yavor7512/cabinet_maker/tests/fixtures/pre-config/complete-cabinet-autocad.step

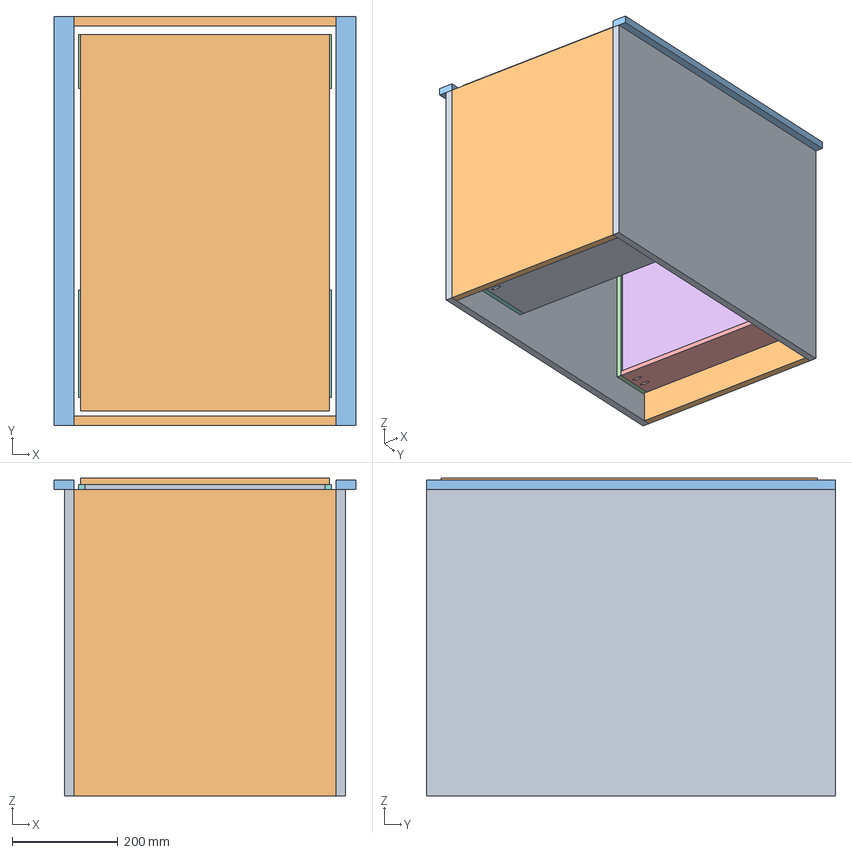
[picture p1: CAD file, 2026-10-23]
tests/fixtures/pre-config/complete-cabinet-autocad.step
570.0 x 773.0 x 600.5 mm
B12 - Left carcass side
B13 - Right carcass side
B14 - Carcass bottom
B15 - Carcass top
B16 - Left face-frame stile
B17 - Right face-frame stile
B01 - Left side
B02 - Right side
B03 - Front wall
B04 - Back wall
B05 - Bottom panel
S01 - Front left pocket screw 1 x 2
S02 - Front left pocket screw 2 x 2
S03 - Front right pocket screw 1 x 2
S04 - Front right pocket screw 2 x 2
S05 - Back left pocket screw 1 x 2
S06 - Back left pocket screw 2 x 2
S07 - Back right pocket screw 1 x 2
S08 - Back right pocket screw 2 x 2
B06 - Left side
B07 - Right side
B08 - Front wall
B09 - Back wall
B10 - Bottom panel
B11 - Applied drawer face
