yavor7512/cabinet_maker/tests/fixtures/pre-config/inner-drawer-477x523x102.step

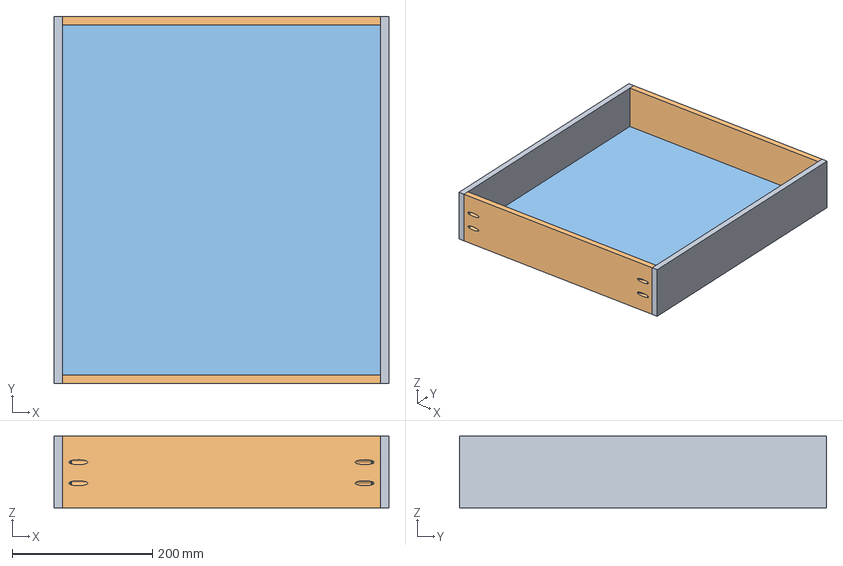
[picture p2: CAD file, 2026-10-23]
tests/fixtures/pre-config/inner-drawer-477x523x102.step
477.0 x 523.0 x 102.0 mm
B01 - Left side
B02 - Right side
B03 - Front wall
B04 - Back wall
B05 - Bottom panel
S01 - Front left pocket screw 1
S02 - Front left pocket screw 2
S03 - Front right pocket screw 1
S04 - Front right pocket screw 2
S05 - Back left pocket screw 1
S06 - Back left pocket screw 2
S07 - Back right pocket screw 1
S08 - Back right pocket screw 2
