yavor7512/cabinet_maker/tests/fixtures/pre-config/tall-front-bottom-aligned.step

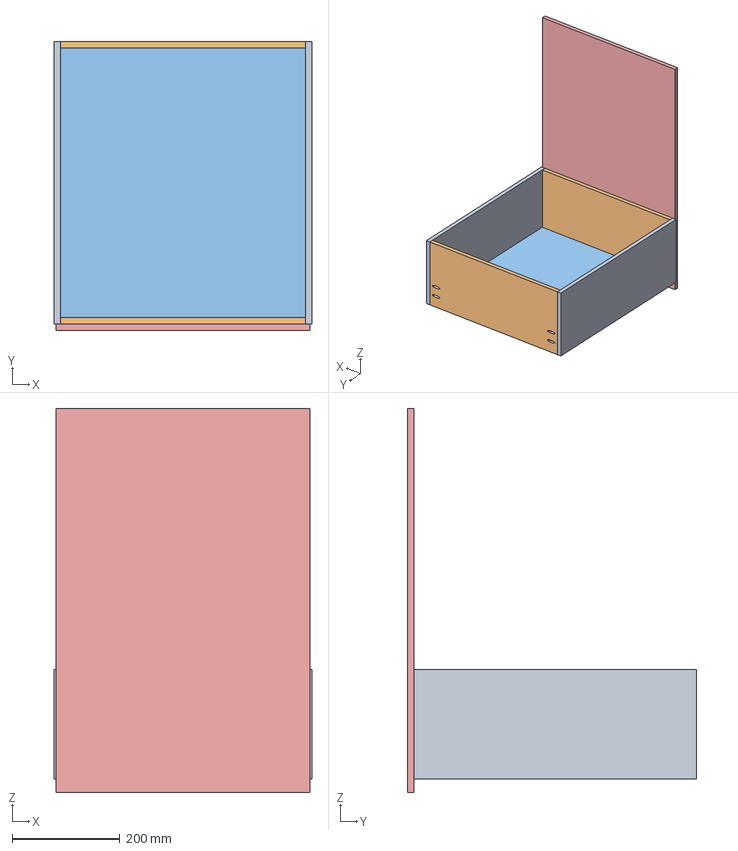
[picture p3: CAD file, 2026-10-23]
tests/fixtures/pre-config/tall-front-bottom-aligned.step
477.0 x 535.0 x 711.2 mm
B06 - Left side
B07 - Right side
B08 - Front wall
B09 - Back wall
B10 - Bottom panel
S01 - Front left pocket screw 1
S02 - Front left pocket screw 2
S03 - Front right pocket screw 1
S04 - Front right pocket screw 2
S05 - Back left pocket screw 1
S06 - Back left pocket screw 2
S07 - Back right pocket screw 1
S08 - Back right pocket screw 2
B11 - Applied drawer face
