yavor7512/cabinet_maker/tests/fixtures/pre-config/cabinet-carcass.step

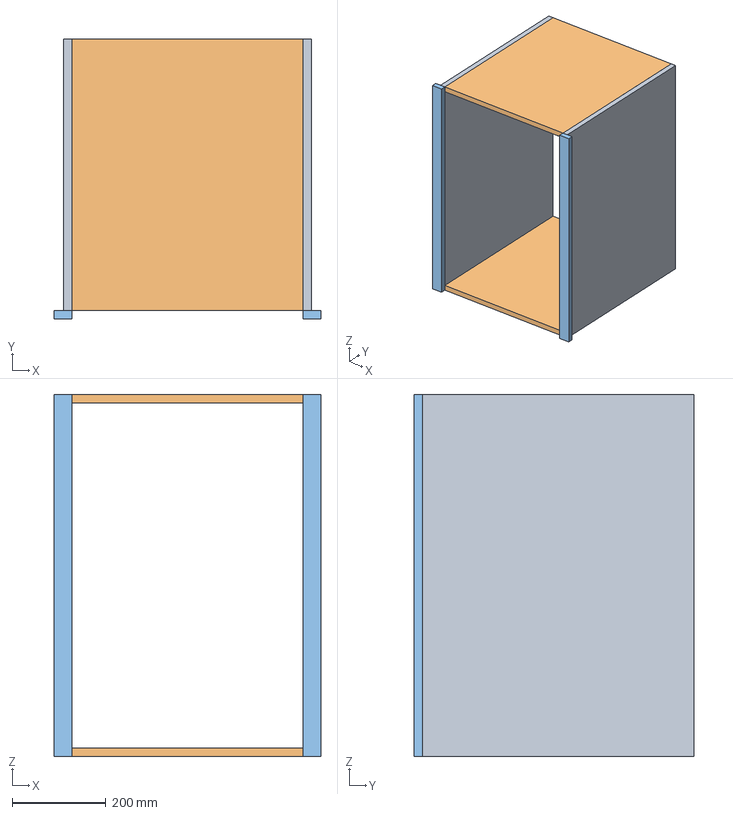
[picture p4: CAD file, 2026-10-23]
tests/fixtures/pre-config/cabinet-carcass.step
570.0 x 597.0 x 773.0 mm
B12 - Left carcass side
B13 - Right carcass side
B14 - Carcass bottom
B15 - Carcass top
B16 - Left face-frame stile
B17 - Right face-frame stile
