yavor7512/cabinet_maker/(list of files, cad)

Other CAD files:
tests/fixtures/pre-config/complete-cabinet.step
