yavor7512/cabinet_maker/tests/fixtures/pre-config/shop-packet.pdf

FABRICATION / PLYWOOD

# Plywood cutting plan

Production overview / Rectangular blanks first, machining second

2

SHEETS TO BUY

17

INDIVIDUAL BLANKS

24

SAW CUTS

5 mm

MAX. KERF ALLOWANCE

01 STOCK TO BUY

SHEET | PLYWOOD | STOCK SIZE | USABLE SIZE (MM) | BLANKS | CUTS
1.1 | 12 mm | 5x5 ft | 1524 x 1524 | 11 | 16
2.1 | 18 mm | 5x5 ft | 1524 x 1524 | 6 | 8

02 CUTTING WORKFLOW

1 Follow FROM and KEEP LEFT for each cut; see the cutting guide on the next page. 2 Mark every blank with its P ID before separating similar parts.
3 Machine flagged parts using the source model / drawings before assembly.

Grain: longest blank edge follows sheet X. Preserve the layout when turning panels.
Usable stock sizes assumed; no edge-trim allowance. No stacked cuts assumed.
Material / grade assumed uniform; sheets grouped by thickness. 16 hardware objects excluded.

Plan: shop workflow. Search is heuristic; minimum cut count is not proven.

SOURCE complete-cabinet.step

SHOP PACKET / DIMENSIONS IN MM / NOT TO SCALE | Page 1 / 5

# Keep the sized piece on the left

Use local measurements for every cut / Diagram positions use the maximum kerf allowance

01 PICK THE CORRECT SUBPANEL
FROM identifies the piece: S1 = this group's sheet 1; C4L = left piece from cut 4; C4R = right remainder. After each cut, label both sides CnL / CnR and retain any remainder referenced by a later cut.

02 ORIENT IT BEFORE MEASURING
V: put the diagram-left edge on your left. H: turn clockwise so the diagram-bottom edge is on your left.
Use the sheet diagram as the orientation reference each time. Turning a panel does not change its grain layout.

03 MEASURE KEEP LEFT TO THE NEAREST CUTTING EDGE
Measure from the current left reference edge to the blade tooth edge nearest the kept piece, not the blade centre. Reset this measurement for every cut. Do not use cumulative sheet coordinates or subtract the kerf.
KEEP LEFT | RIGHT REMAINDER
KEEP LEFT dimension | Kerf is taken from this side

04 FINISH REMAINDERS TO SIZE
The plan reserves 5 mm per cut. Smaller actual kerfs leave extra stock; finishing cuts remove it.
Finish even at a diagram edge. Skip a pass only if the piece measures to size; still use its CnL label.
The actual kerf must be no greater than 5 mm. Replan for a wider blade. Exact stock size and accurate setup still matter.

P IDs in LEFT PIECE mark finished blanks. Other left pieces and right remainders may need further cuts.

# Parts register

One row per physical blank. P IDs link this register to layouts and labels.

ID | PART / MODEL BOARD NAME | LENGTH | WIDTH | THICK. | QTY | FINISHING
P01 | B12 - Left carcass side | 773 | 579 | 18 | 1 | Blank
P02 | B13 - Right carcass side | 773 | 579 | 18 | 1 | Blank
P03 | B14 - Carcass bottom | 579 | 494 | 18 | 1 | Blank
P04 | B15 - Carcass top | 579 | 494 | 18 | 1 | Blank
P05 | B16 - Left face-frame stile | 773 | 38 | 18 | 1 | Blank
P06 | B17 - Right face-frame stile | 773 | 38 | 18 | 1 | Blank
P07 | B01 - Left side | 523 | 102 | 12 | 1 | Machine *
P08 | B02 - Right side | 523 | 102 | 12 | 1 | Machine *
P09 | B03 - Front wall | 453 | 102 | 12 | 1 | Machine *
P10 | B04 - Back wall | 453 | 102 | 12 | 1 | Machine *
P11 | B05 - Bottom panel | 511 | 465 | 12 | 1 | Blank
P12 | B06 - Left side | 523 | 203 | 12 | 1 | Machine *
P13 | B07 - Right side | 523 | 203 | 12 | 1 | Machine *
P14 | B08 - Front wall | 453 | 203 | 12 | 1 | Machine *
P15 | B09 - Back wall | 453 | 203 | 12 | 1 | Machine *
P16 | B10 - Bottom panel | 511 | 465 | 12 | 1 | Blank
P17 | B11 - Applied drawer face | 711.2 | 469.9 | 12 | 1 | Blank

* Additional machining required: dados, holes or other material removal detected.
Machining sizes are not extracted. Use source drawings / model for positions, depths and drilling setups.

# Sheet 1.1 / 12 mm plywood

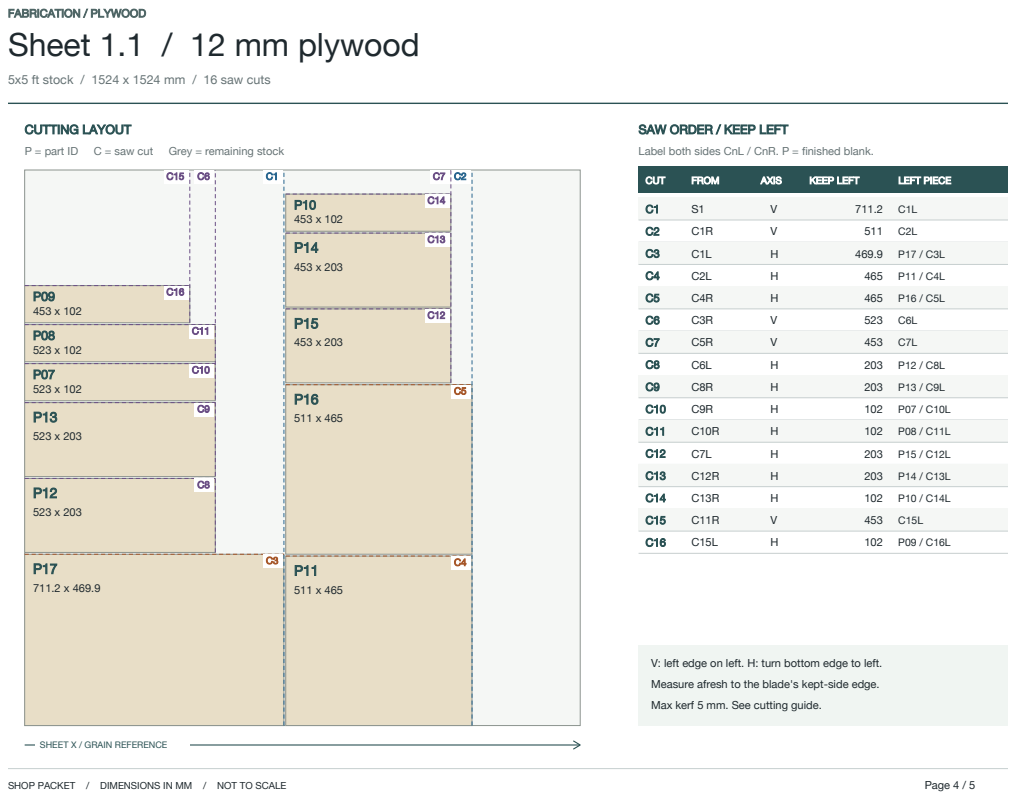
[picture p5: page 4]

5x5 ft stock / 1524 x 1524 mm / 16 saw cuts

CUTTING LAYOUT
P = part ID C = saw cut Grey = remaining stock

SAW ORDER / KEEP LEFT
Label both sides CnL / CnR. P = finished blank.

V: left edge on left. H: turn bottom edge to left.
Measure afresh to the blade's kept-side edge.
Max kerf 5 mm. See cutting guide.

# Sheet 2.1 / 18 mm plywood

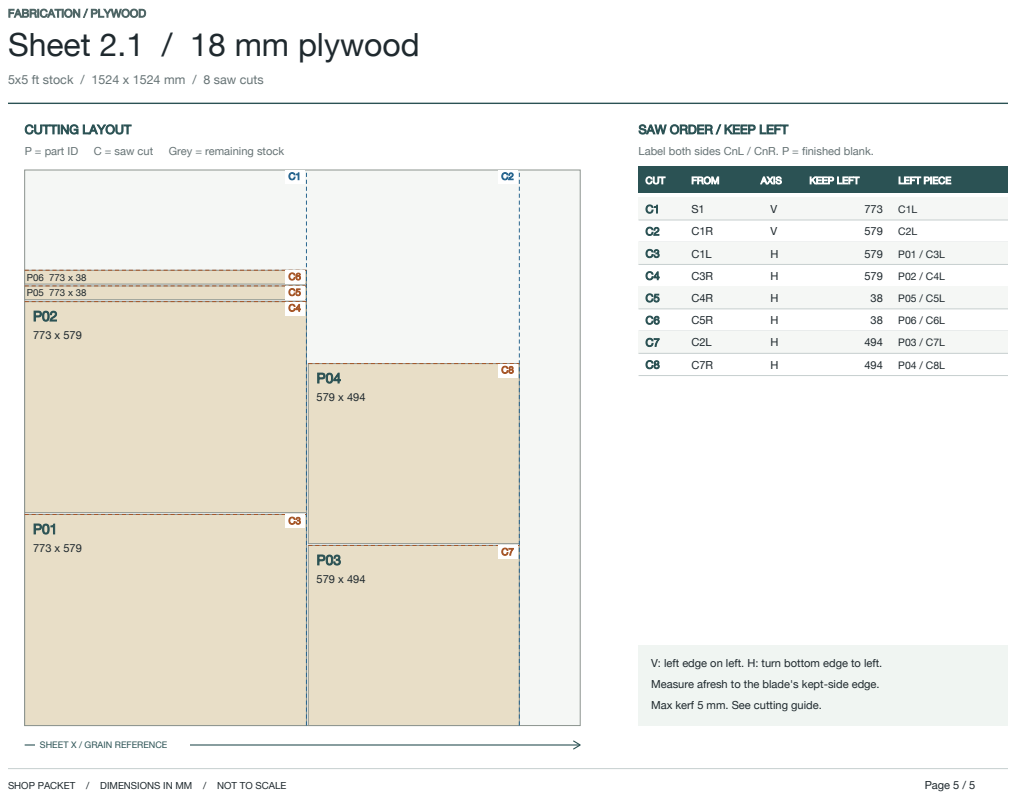
[picture p6: page 5]

5x5 ft stock / 1524 x 1524 mm / 8 saw cuts

CUTTING LAYOUT
P = part ID C = saw cut Grey = remaining stock

SAW ORDER / KEEP LEFT
Label both sides CnL / CnR. P = finished blank.

V: left edge on left. H: turn bottom edge to left.
Measure afresh to the blade's kept-side edge.
Max kerf 5 mm. See cutting guide.
