yavor7512/cabinet_maker/src/geometry.hpp

#pragma once
#include <BRepAlgoAPI_Cut.hxx>
#include <BRepBuilderAPI_Transform.hxx>
#include <BRep_Builder.hxx>
#include <TopoDS_Compound.hxx>
#include <vector>
#include <BRepCheck_Analyzer.hxx>
#include <BRepGProp.hxx>
#include <BRepBndLib.hxx>
#include <BRepPrimAPI_MakeBox.hxx>
#include <Bnd_Box.hxx>
#include <GProp_GProps.hxx>
#include <Interface_Static.hxx>
#include <STEPControl_Reader.hxx>
#include <STEPControl_Writer.hxx>
#include <Standard_Failure.hxx>
#include <TopExp_Explorer.hxx>
#include <gp_Pnt.hxx>
#include <algorithm>
#include <cmath>
#include <filesystem>
#include <iostream>
#include <stdexcept>
#include <string>

#include "validation.hpp"
#include "shape_utils.hpp"
#include "step_export.hpp"
