yavor7512/cabinet_maker/(commit log)

2026-10-23 Add cabinet generator, Jsonnet designs, cut planning and regression fixtures
    [cabinet-carcass.step, complete-cabinet-autocad.step, complete-cabinet.step, inner-drawer-477x523x102.step, tall-front-bottom-aligned.step]
2026-10-23 Make cabinet construction entirely configuration driven
    Remove legacy drawer/carcass generators and their dimensional CLI. Discover named assemblies, export filenames and merge order from Jsonnet, with generic Make selection and existing cabinet shortcuts.
    Verified 40 configuration/geometry tests, cut-list and merger tests, 23 cold-build targets, all frozen STEP references and byte-for-byte PDF equivalence.
    [design.hpp, geometry.hpp, main.cpp, project_cli.hpp, project_geometry.hpp, shape_utils.hpp, step_export.hpp]
2026-10-23 Harden STEP exports, part roles, clearance checks and cut planning
    Use explicit STEP role metadata, verified atomic exports, cross-group pocket checks with cached bounds, and a shared cut-plan traversal. Expand regression coverage while preserving the reference models and shop packet.
    Validation: make test passes, including all 40 generator tests, both cut-list tests, merger checks, and frozen model/PDF comparisons.
    [main.cpp, model.hpp, part_role.hpp, project_cli.hpp, project_geometry.hpp, saw.hpp]
